snipeexpress/ISA-PC104-Backplane/ISA_PC104 Backplane.kicad_sch

## KiCad design ISA_PC104 Backplane.kicad_sch (2024-09-26)

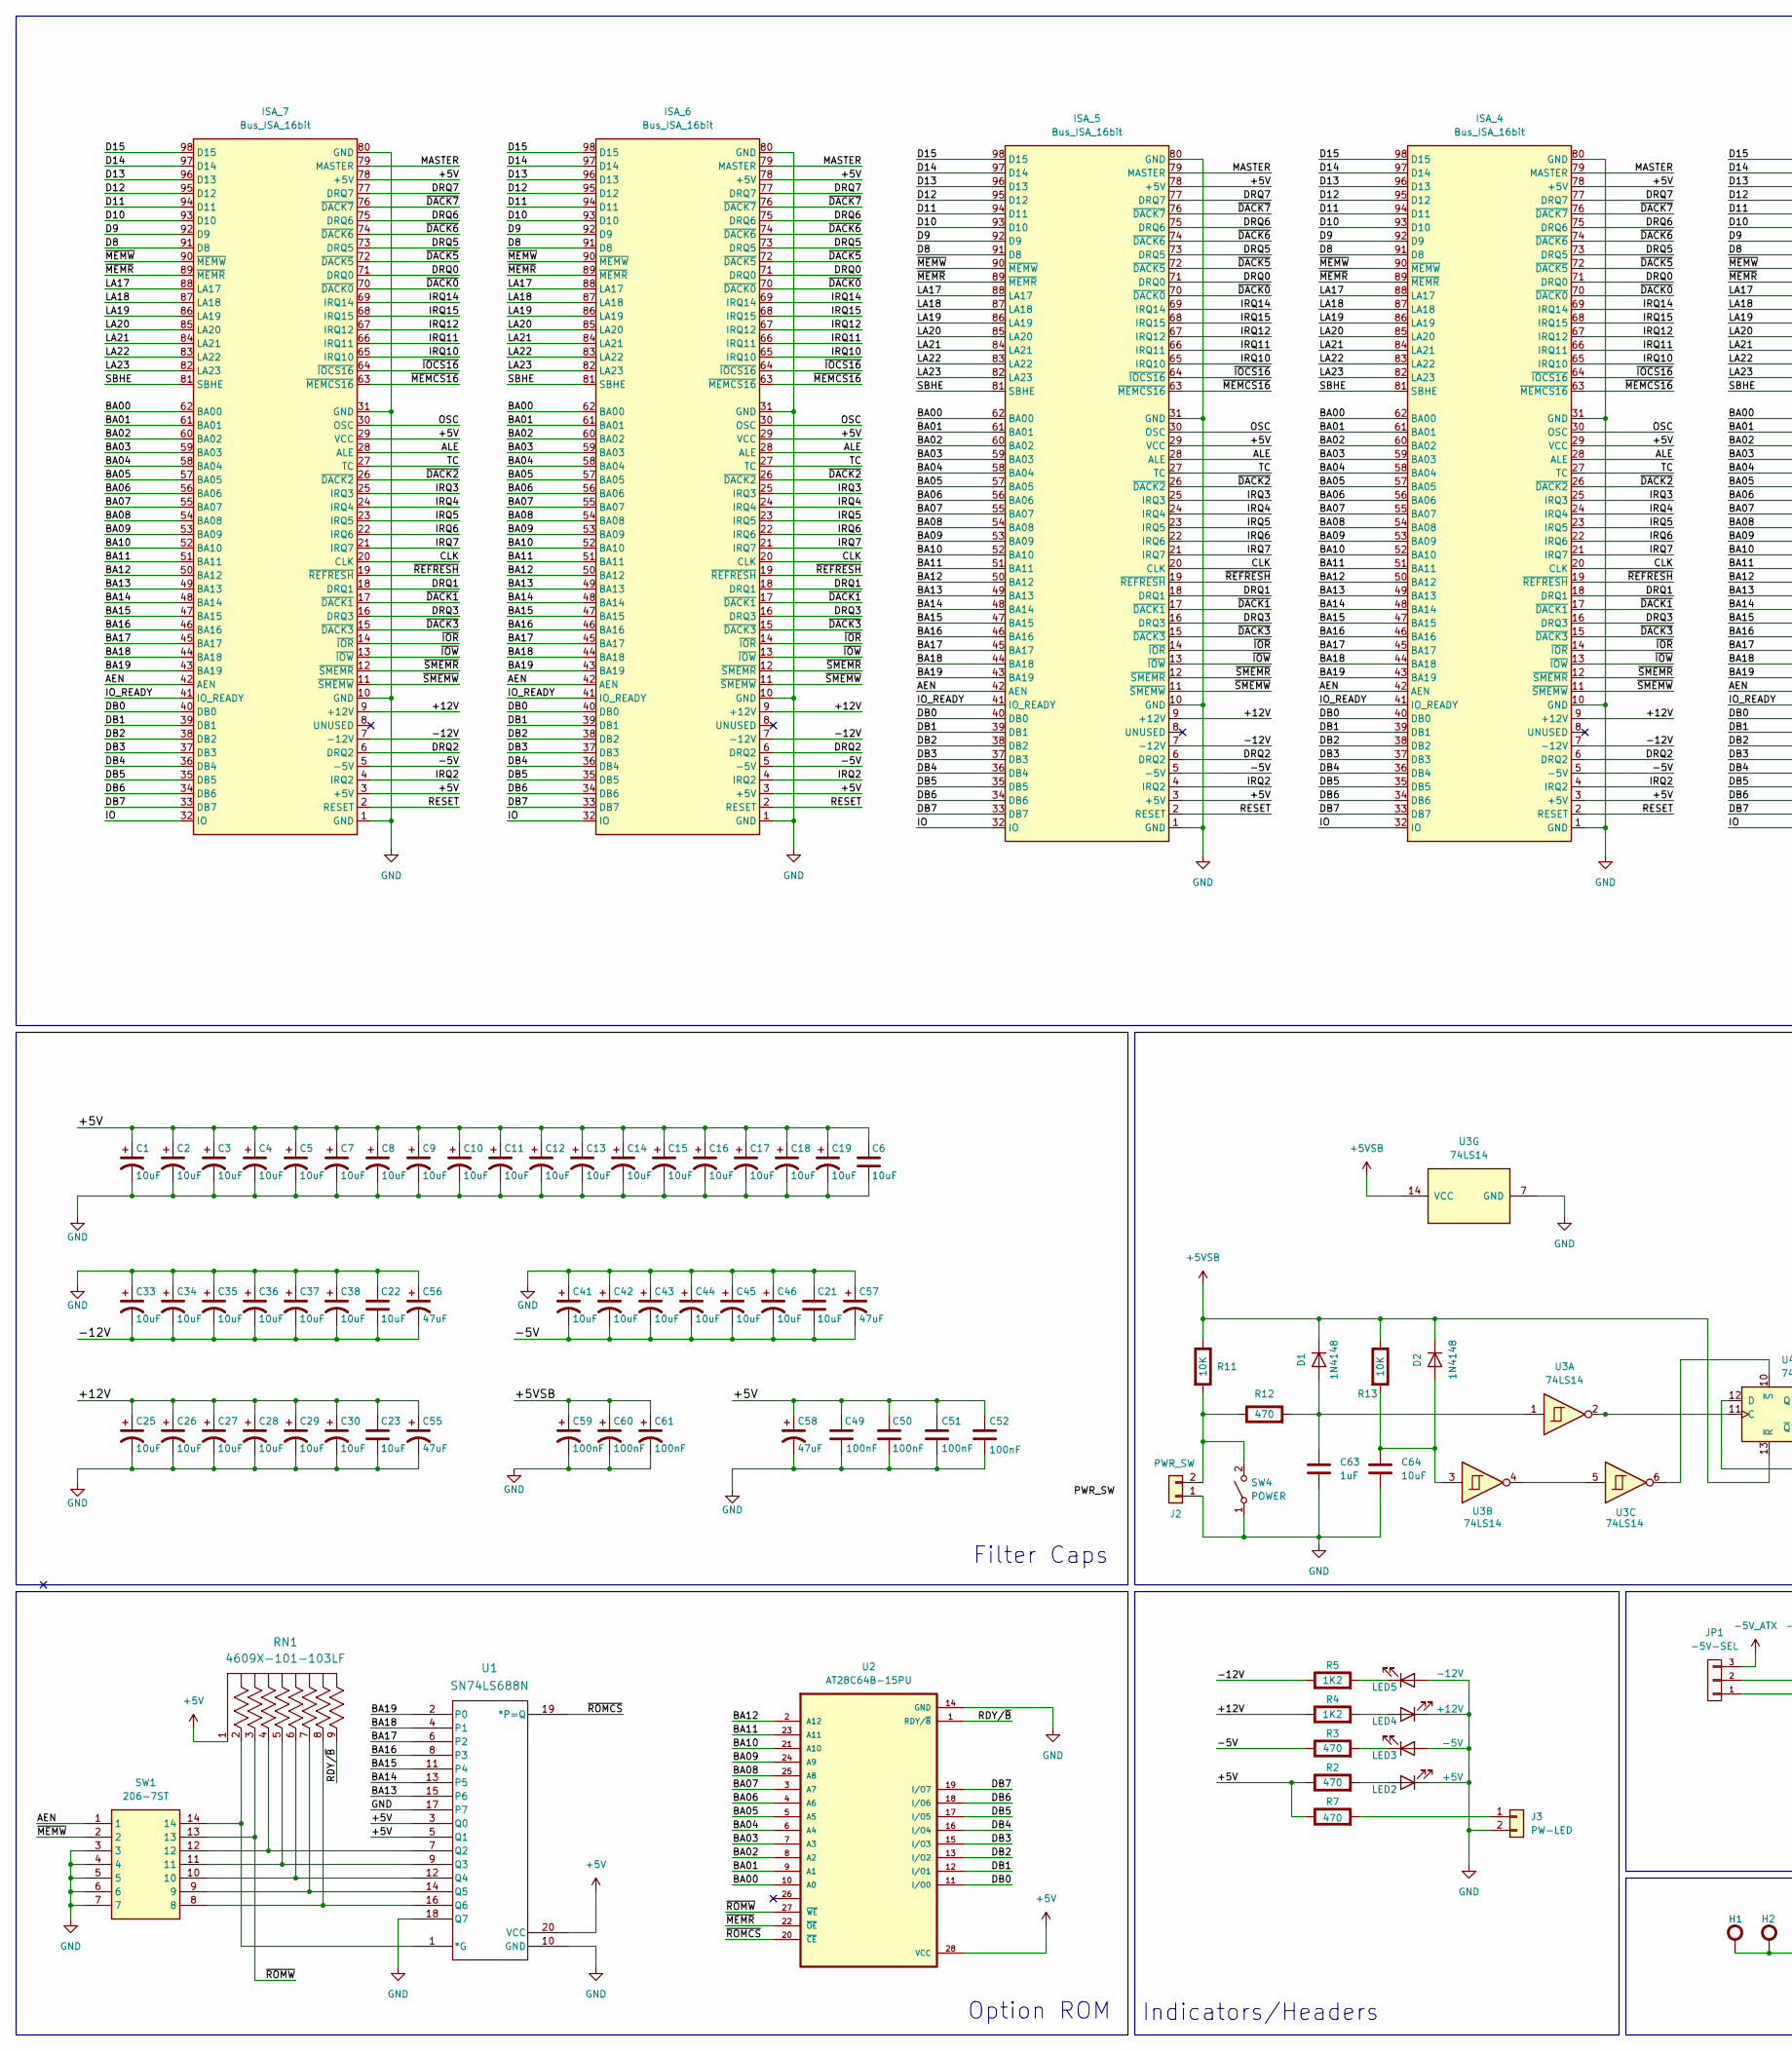
[picture p1: schematic ISA_PC104 Backplane.kicad_sch, part in row 1, column 1]

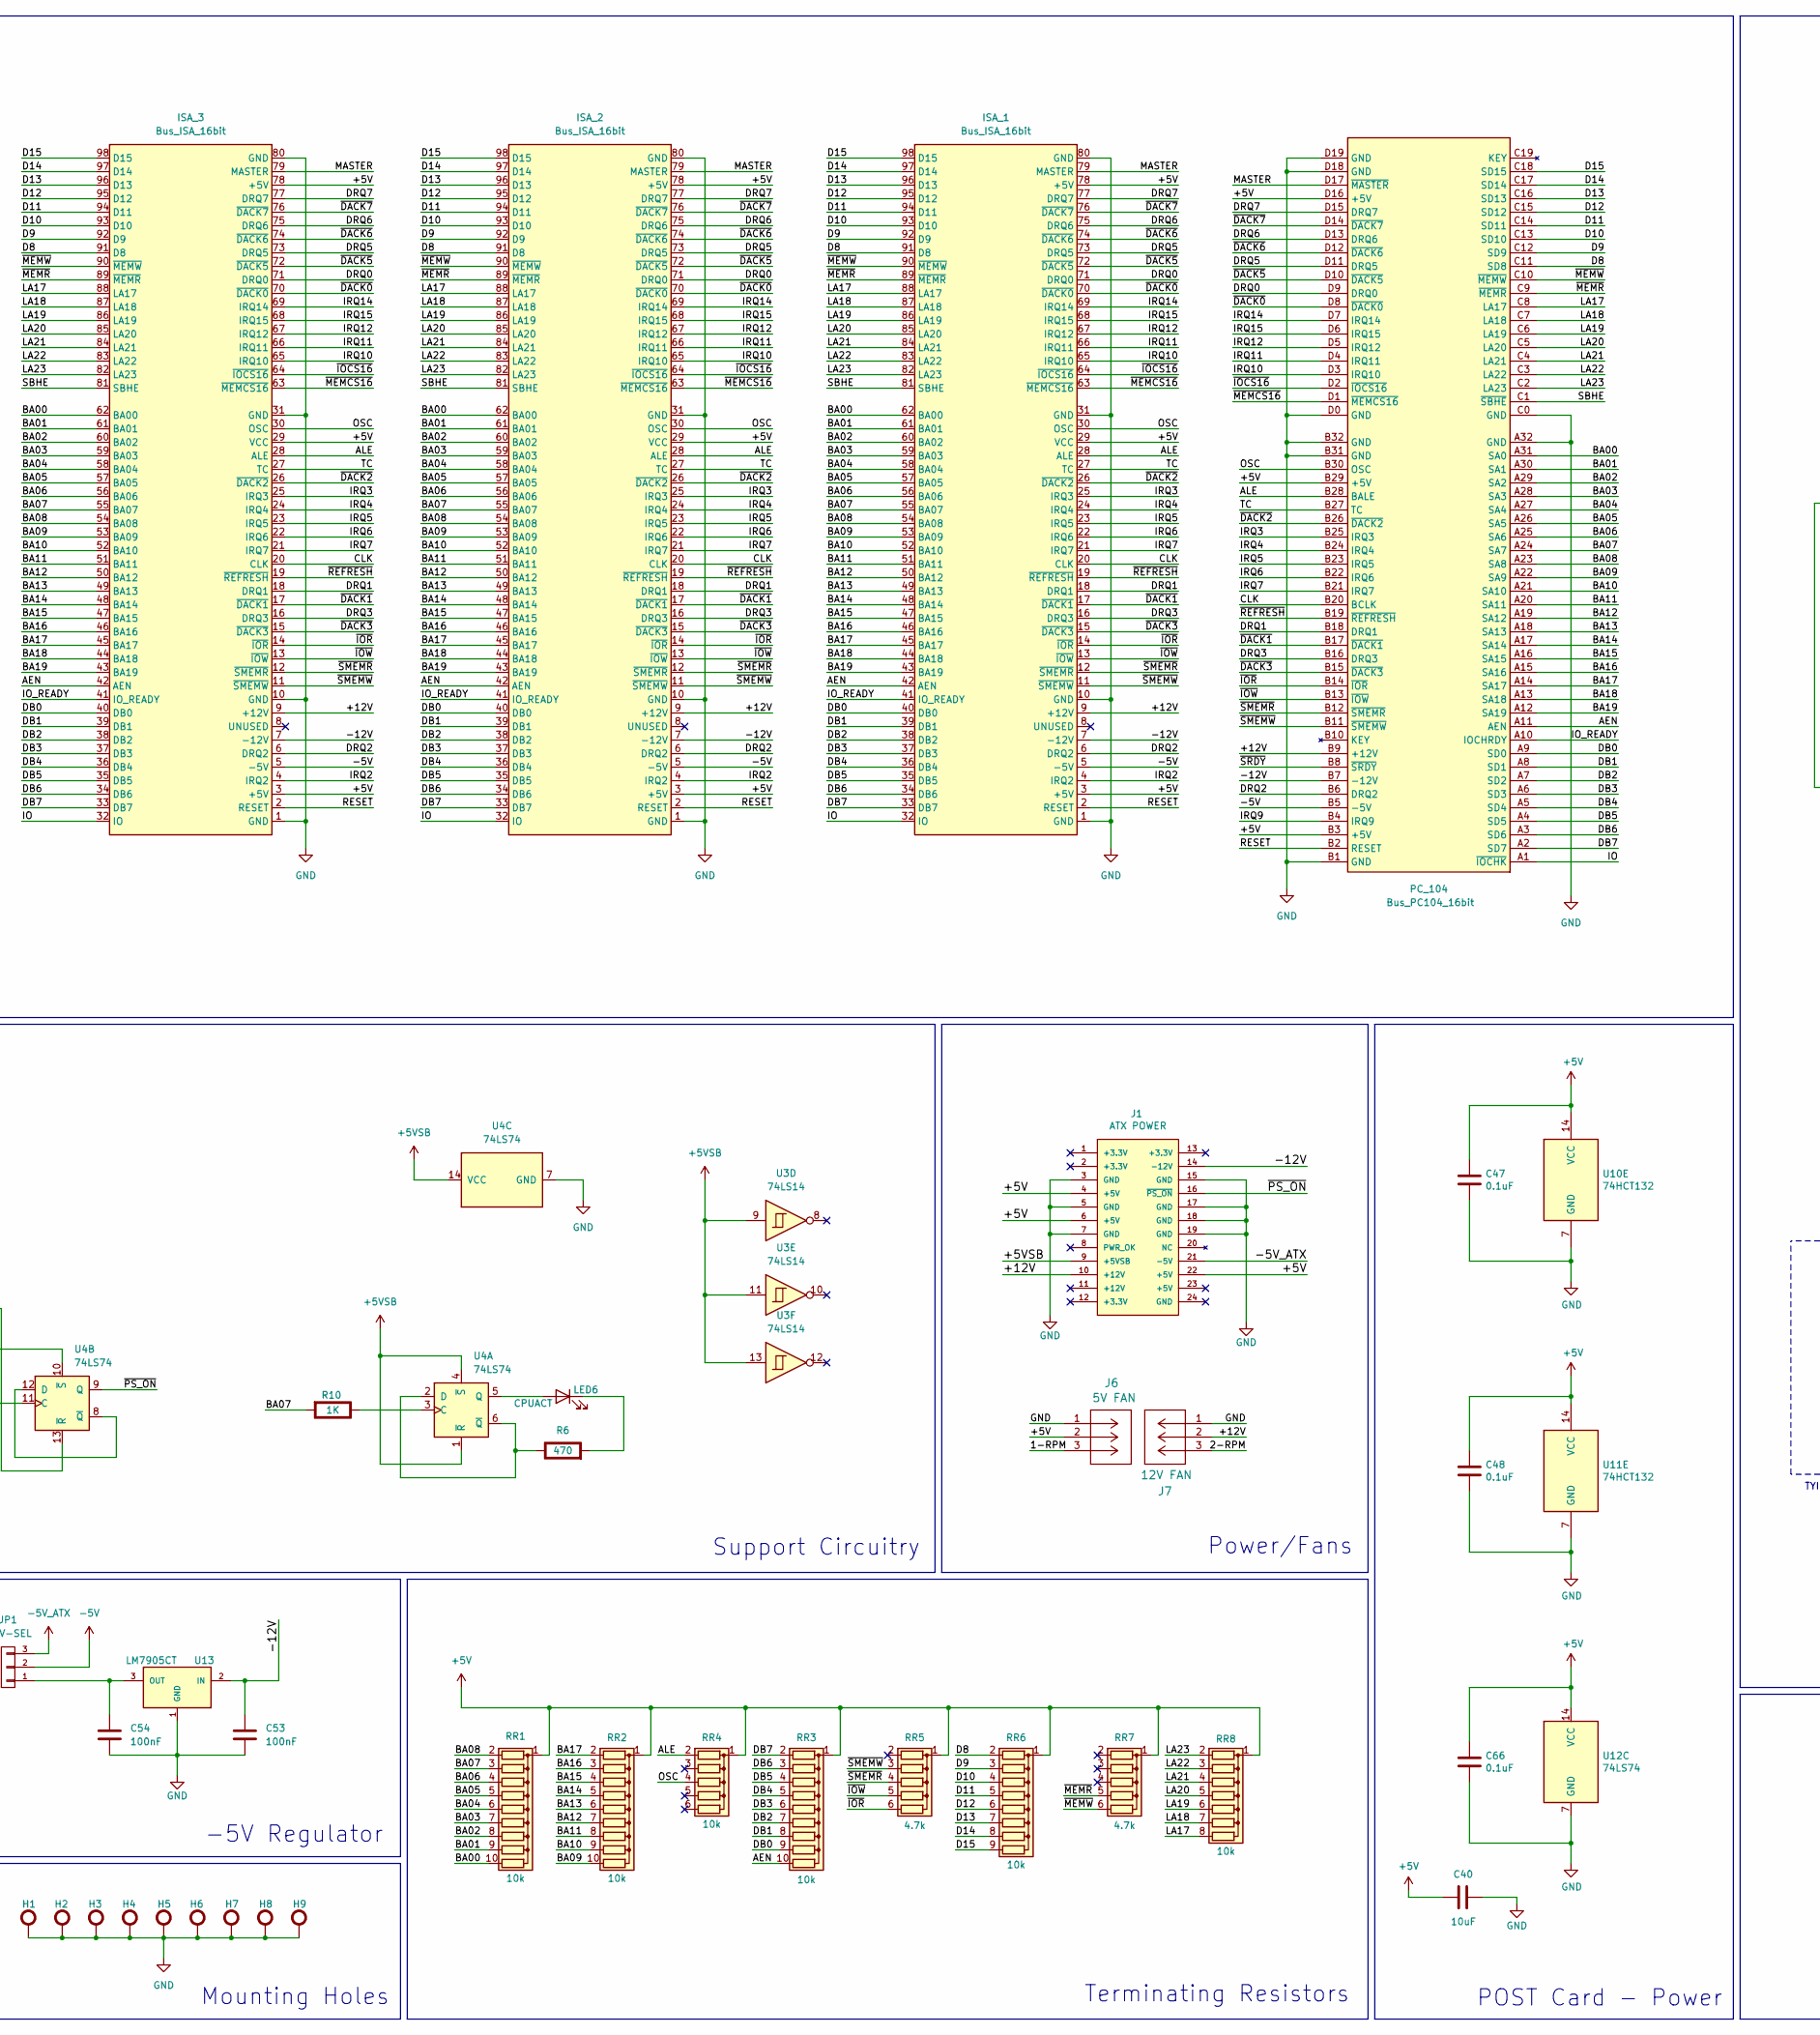
[picture p2: schematic ISA_PC104 Backplane.kicad_sch, part in row 1, column 2]

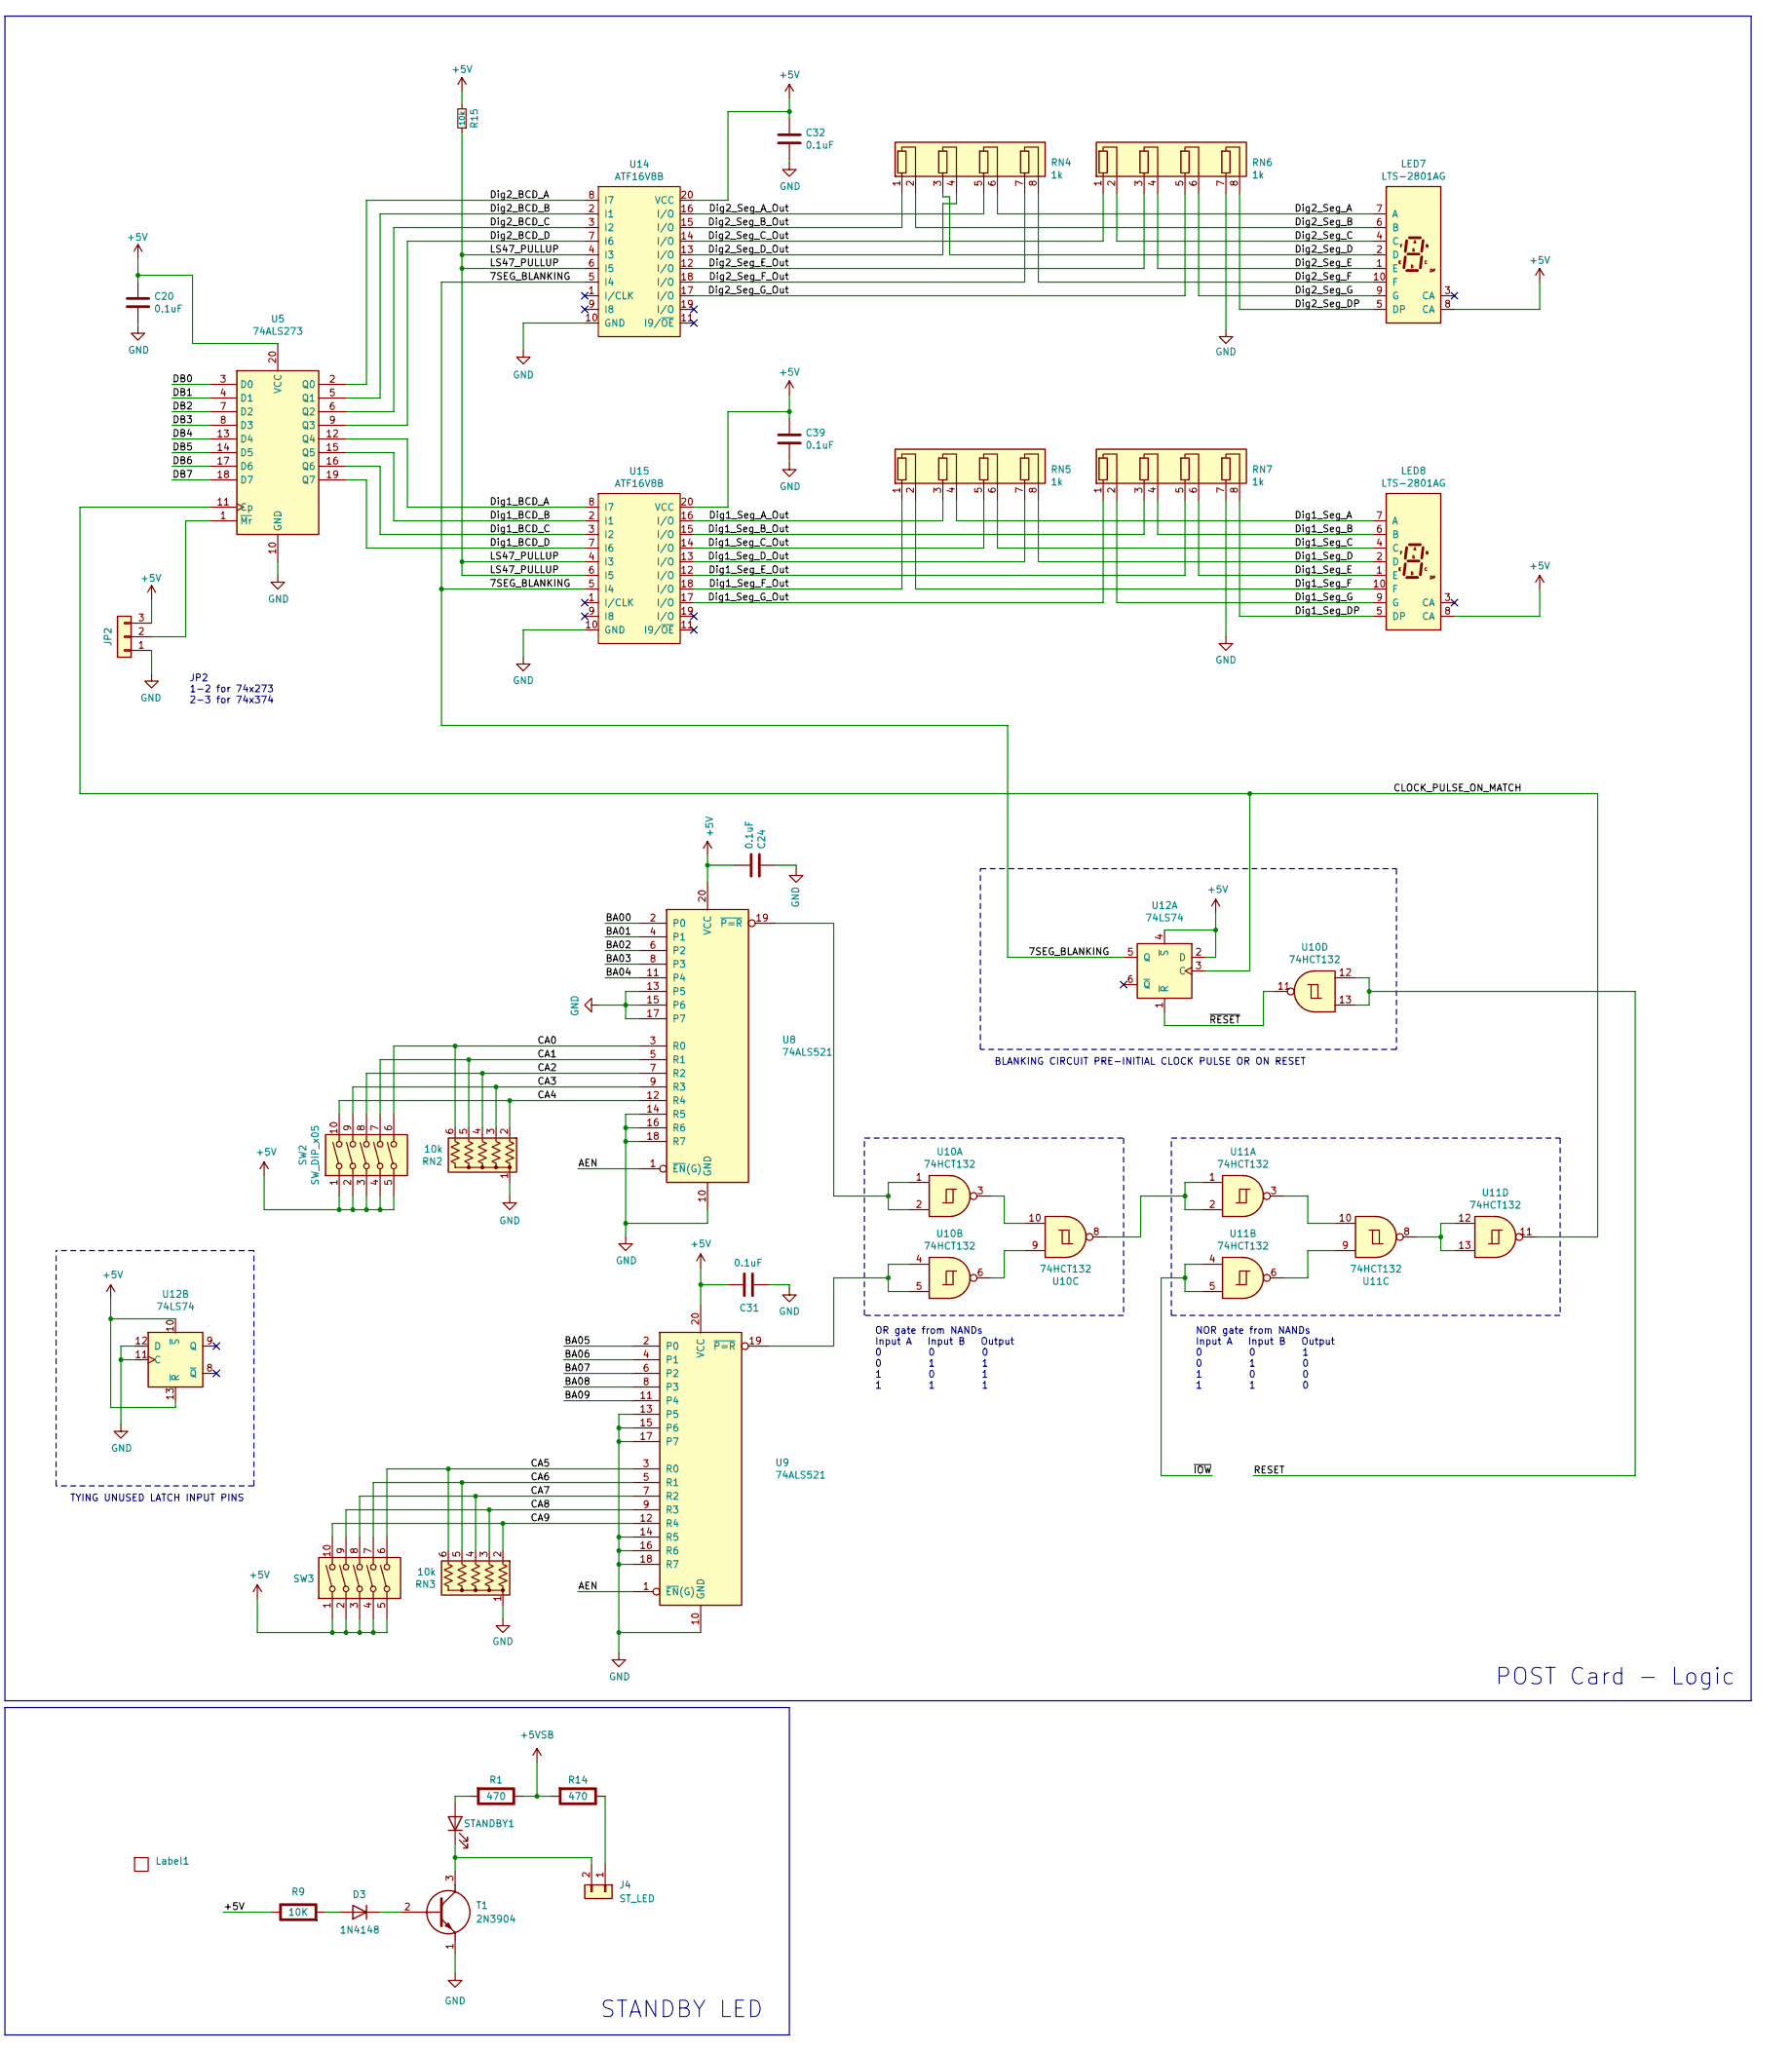
[picture p3: schematic ISA_PC104 Backplane.kicad_sch, part in row 1, column 3]

Parts:
C1, C2, C3, C4, C5, C7, C8, C9, C10, C11, C12, C13, C14, C15, C16, C17, C18, C19, C25, C26, C27, C28, C29, C30, C33, C34, C35, C36, C37, C38, C41, C42, C43, C44, C45, C46, C64: 10uF; CAP_T350E_5p5X5p5-2p54_KEM
C6, C21, C22, C23: 10uF; C_1206_3216Metric
C20, C24, C31, C32, C39, C47, C48, C66: 0.1uF; CAP22
C40: 10uF; CAP22
C49, C50, C51, C52, C53, C54, C59, C60, C61: 100nF; CAP22
C55, C56, C57, C58: 47uF; CAP_PL_10X13_NCH
C63: 1uF; CAP_T350E_5p5X5p5-2p54_KEM
D1, D2, D3: 1N4148; DIOAD990W55L340D162
H1, H2, H3, H4, H5, H6, H7, H8, H9: H_HOLE; MountingHole_4.3mm_M4_Pad_Via
ISA_1, ISA_2, ISA_3, ISA_4, ISA_5, ISA_6, ISA_7: Bus_ISA_16bit; BP_ISA_16BIT_SQ
J1: ATX POWER; J_ATX_5.5mm
J2: PWR_SW; P_CONN_01X02
J3: PW-LED; P_CONN_01X02
J4: ST_LED; P_CONN_01X02
J6: 5V FAN; CONN3_22232031_MOL
J7: 12V FAN; CONN3_22232031_MOL
JP1: -5V-SEL; P_CONN_01X03
JP2: Conn_01x03; P_CONN_01X03
LED2: +5V; LED_D5.0mm
LED3: -5V; LED_D5.0mm
LED4: +12V; LED_D5.0mm
LED5: -12V; LED_D5.0mm
LED6: CPUACT; LED_D5.0mm
LED7, LED8: LTS-2801AG; 7SEG_LED_0.58
Label1: OSHW-Logo2_9.8x8mm_SilkScreen
PC_104: Bus_PC104_16bit; PC104_16bit
R1, R2, R3, R6, R7, R12, R14: 470; STA_CF14_STP; Rating W
R4, R5: 1K2; STA_CF14_STP; Rating W
R9, R11, R13: 10K; STA_CF14_STP; Rating W
R10: 1K; STA_CF14_STP; Rating W
R15: 10k; R_Axial_DIN0207_L6.3mm_D2.5mm_P10.16mm_Horizontal
RN1: 4609X-101-103LF; BO_4609X
RN2, RN3: 10k; R_Array_SIP6
RN4, RN5, RN6, RN7: 1k; R_Array_SIP8
RR1, RR2, RR3: 10k; R_Array_SIP10
RR4: 10k; R_Array_SIP6
RR5, RR7: 4.7k; R_Array_SIP6
RR6: 10k; R_Array_SIP9
RR8: 10k; R_Array_SIP8
STANDBY1: STDBY; LED_D5.0mm
SW1: 206-7ST; Switch_DIP_7_Positions; Mouser Part Number 774-2067ST
SW2, SW3: SW_DIP_x05; SW_DIP_SPSTx05_Slide_9.78x14.88mm_W7.62mm_P2.54mm
SW4: POWER; SW_B3FS-1010
T1: 2N3904; TO92127P495H495-3; Mouser Part Number 610-2N2222
U1: SN74LS688N; DIP300_20N
U2: AT28C64B-15PU; DIP1555W45P254L3733H482Q28; PARTREV B
U3: 74LS14; 1109931441001000
U4: 74LS74; 1109931441001000
U5: 74ALS273; DIP-20_W7.62mm
U8, U9: 74ALS521; DIP-20_W7.62mm
U10, U11: 74HCT132; U_DIP-14_W7.62mm
U12: 74LS74; U_DIP-14_W7.62mm
U13: LM7905CT; SB_TO220
U14, U15: ATF16V8B; DIP-20_W7.62mm

Connections:
1-RPM: J6.3
2-RPM: J7.3
7SEG_BLANKING: U12.5 (Q), U14.5 (I4), U15.5 (I4)
+5V: C1.1, C2.1, C3.1, C4.1, C5.1, C6.1, C7.1, C8.1, C9.1, C10.1, C11.1, C12.1, C13.1, C14.1, C15.1, C16.1, C17.1, C18.1, C19.1, C20.1, C24.2, C31.2, C32.1, C39.1, C40.1, C47.1, C48.1, C49.1, C50.1, C51.1, C52.1, C58.1, C66.1, ISA_1.3 (+5V), ISA_1.29 (VCC), ISA_1.78 (+5V), ISA_2.3 (+5V), ISA_2.29 (VCC), ISA_2.78 (+5V), ISA_3.3 (+5V), ISA_3.29 (VCC), ISA_3.78 (+5V), ISA_4.3 (+5V), ISA_4.29 (VCC), ISA_4.78 (+5V), ISA_5.3 (+5V), ISA_5.29 (VCC), ISA_5.78 (+5V), ISA_6.3 (+5V), ISA_6.29 (VCC), ISA_6.78 (+5V), ISA_7.3 (+5V), ISA_7.29 (VCC), ISA_7.78 (+5V), J1.4 (+5V), J1.6 (+5V), J1.22 (+5V), J6.2, JP2.3, LED7.8 (CA), LED8.8 (CA), PC_104.B3 (+5V), PC_104.B29 (+5V), PC_104.D16 (+5V), R2.1 (+), R7.1 (+), R9.1 (+), R15.2, RN1.1, RR1.1 (common), RR2.1 (common), RR3.1 (common), RR4.1 (common), RR5.1 (common), RR6.1 (common), RR7.1 (common), RR8.1 (common), SW2.1, SW2.2, SW2.3, SW2.4, SW2.5, SW3.1, SW3.2, SW3.3, SW3.4, SW3.5, U1.3 (Q0), U1.5 (Q1), U1.20 (VCC), U2.28 (VCC), U5.20 (VCC), U8.20 (VCC), U9.20 (VCC), U10.14 (VCC), U11.14 (VCC), U12.2 (D), U12.4 (~S), U12.10 (~S), U12.13 (~R), U12.14 (VCC), U14.20 (VCC), U15.20 (VCC)
+5VSB: C59.1, C60.1, C61.1, D1.1 (K), D2.1 (K), J1.9 (+5VSB), R1.1 (+), R11.1 (+), R13.1 (+), R14.2 (-), U3.9, U3.11, U3.13, U3.14 (VCC), U4.1 (~R), U4.4 (~S), U4.13 (~R), U4.14 (VCC)
+12V: C23.1, C25.1, C26.1, C27.1, C28.1, C29.1, C30.1, C55.1, ISA_1.9 (+12V), ISA_2.9 (+12V), ISA_3.9 (+12V), ISA_4.9 (+12V), ISA_5.9 (+12V), ISA_6.9 (+12V), ISA_7.9 (+12V), J1.10 (+12V), J7.2, PC_104.B9 (+12V), R4.1 (+)
-5V: C21.2, C41.2, C42.2, C43.2, C44.2, C45.2, C46.2, C57.2, ISA_1.5 (-5V), ISA_2.5 (-5V), ISA_3.5 (-5V), ISA_4.5 (-5V), ISA_5.5 (-5V), ISA_6.5 (-5V), ISA_7.5 (-5V), JP1.2, PC_104.B5 (-5V), R3.1 (+)
-5V_ATX: J1.21 (-5V), JP1.3
-12V: C22.2, C33.2, C34.2, C35.2, C36.2, C37.2, C38.2, C53.1, C56.2, ISA_1.7 (-12V), ISA_2.7 (-12V), ISA_3.7 (-12V), ISA_4.7 (-12V), ISA_5.7 (-12V), ISA_6.7 (-12V), ISA_7.7 (-12V), J1.14 (-12V), PC_104.B7 (-12V), R5.1 (+), U13.2 (IN)
AEN: ISA_1.42 (AEN), ISA_2.42 (AEN), ISA_3.42 (AEN), ISA_4.42 (AEN), ISA_5.42 (AEN), ISA_6.42 (AEN), ISA_7.42 (AEN), PC_104.A11 (AEN), RR3.10 (R9), SW1.1, U8.1 (~EN(G)), U9.1 (~EN(G))
ALE: ISA_1.28 (ALE), ISA_2.28 (ALE), ISA_3.28 (ALE), ISA_4.28 (ALE), ISA_5.28 (ALE), ISA_6.28 (ALE), ISA_7.28 (ALE), PC_104.B28 (BALE), RR4.2 (R1)
BA00: ISA_1.62 (BA00), ISA_2.62 (BA00), ISA_3.62 (BA00), ISA_4.62 (BA00), ISA_5.62 (BA00), ISA_6.62 (BA00), ISA_7.62 (BA00), PC_104.A31 (SA0), RR1.10 (R9), U2.10 (A0), U8.2 (P0)
BA01: ISA_1.61 (BA01), ISA_2.61 (BA01), ISA_3.61 (BA01), ISA_4.61 (BA01), ISA_5.61 (BA01), ISA_6.61 (BA01), ISA_7.61 (BA01), PC_104.A30 (SA1), RR1.9 (R8), U2.9 (A1), U8.4 (P1)
BA02: ISA_1.60 (BA02), ISA_2.60 (BA02), ISA_3.60 (BA02), ISA_4.60 (BA02), ISA_5.60 (BA02), ISA_6.60 (BA02), ISA_7.60 (BA02), PC_104.A29 (SA2), RR1.8 (R7), U2.8 (A2), U8.6 (P2)
BA03: ISA_1.59 (BA03), ISA_2.59 (BA03), ISA_3.59 (BA03), ISA_4.59 (BA03), ISA_5.59 (BA03), ISA_6.59 (BA03), ISA_7.59 (BA03), PC_104.A28 (SA3), RR1.7 (R6), U2.7 (A3), U8.8 (P3)
BA04: ISA_1.58 (BA04), ISA_2.58 (BA04), ISA_3.58 (BA04), ISA_4.58 (BA04), ISA_5.58 (BA04), ISA_6.58 (BA04), ISA_7.58 (BA04), PC_104.A27 (SA4), RR1.6 (R5), U2.6 (A4), U8.11 (P4)
BA05: ISA_1.57 (BA05), ISA_2.57 (BA05), ISA_3.57 (BA05), ISA_4.57 (BA05), ISA_5.57 (BA05), ISA_6.57 (BA05), ISA_7.57 (BA05), PC_104.A26 (SA5), RR1.5 (R4), U2.5 (A5), U9.2 (P0)
BA06: ISA_1.56 (BA06), ISA_2.56 (BA06), ISA_3.56 (BA06), ISA_4.56 (BA06), ISA_5.56 (BA06), ISA_6.56 (BA06), ISA_7.56 (BA06), PC_104.A25 (SA6), RR1.4 (R3), U2.4 (A6), U9.4 (P1)
BA07: ISA_1.55 (BA07), ISA_2.55 (BA07), ISA_3.55 (BA07), ISA_4.55 (BA07), ISA_5.55 (BA07), ISA_6.55 (BA07), ISA_7.55 (BA07), PC_104.A24 (SA7), R10.2 (-), RR1.3 (R2), U2.3 (A7), U9.6 (P2)
BA08: ISA_1.54 (BA08), ISA_2.54 (BA08), ISA_3.54 (BA08), ISA_4.54 (BA08), ISA_5.54 (BA08), ISA_6.54 (BA08), ISA_7.54 (BA08), PC_104.A23 (SA8), RR1.2 (R1), U2.25 (A8), U9.8 (P3)
BA09: ISA_1.53 (BA09), ISA_2.53 (BA09), ISA_3.53 (BA09), ISA_4.53 (BA09), ISA_5.53 (BA09), ISA_6.53 (BA09), ISA_7.53 (BA09), PC_104.A22 (SA9), RR2.10 (R9), U2.24 (A9), U9.11 (P4)
BA10: ISA_1.52 (BA10), ISA_2.52 (BA10), ISA_3.52 (BA10), ISA_4.52 (BA10), ISA_5.52 (BA10), ISA_6.52 (BA10), ISA_7.52 (BA10), PC_104.A21 (SA10), RR2.9 (R8), U2.21 (A10)
BA11: ISA_1.51 (BA11), ISA_2.51 (BA11), ISA_3.51 (BA11), ISA_4.51 (BA11), ISA_5.51 (BA11), ISA_6.51 (BA11), ISA_7.51 (BA11), PC_104.A20 (SA11), RR2.8 (R7), U2.23 (A11)
BA12: ISA_1.50 (BA12), ISA_2.50 (BA12), ISA_3.50 (BA12), ISA_4.50 (BA12), ISA_5.50 (BA12), ISA_6.50 (BA12), ISA_7.50 (BA12), PC_104.A19 (SA12), RR2.7 (R6), U2.2 (A12)
BA13: ISA_1.49 (BA13), ISA_2.49 (BA13), ISA_3.49 (BA13), ISA_4.49 (BA13), ISA_5.49 (BA13), ISA_6.49 (BA13), ISA_7.49 (BA13), PC_104.A18 (SA13), RR2.6 (R5), U1.15 (P6)
BA14: ISA_1.48 (BA14), ISA_2.48 (BA14), ISA_3.48 (BA14), ISA_4.48 (BA14), ISA_5.48 (BA14), ISA_6.48 (BA14), ISA_7.48 (BA14), PC_104.A17 (SA14), RR2.5 (R4), U1.13 (P5)
BA15: ISA_1.47 (BA15), ISA_2.47 (BA15), ISA_3.47 (BA15), ISA_4.47 (BA15), ISA_5.47 (BA15), ISA_6.47 (BA15), ISA_7.47 (BA15), PC_104.A16 (SA15), RR2.4 (R3), U1.11 (P4)
BA16: ISA_1.46 (BA16), ISA_2.46 (BA16), ISA_3.46 (BA16), ISA_4.46 (BA16), ISA_5.46 (BA16), ISA_6.46 (BA16), ISA_7.46 (BA16), PC_104.A15 (SA16), RR2.3 (R2), U1.8 (P3)
BA17: ISA_1.45 (BA17), ISA_2.45 (BA17), ISA_3.45 (BA17), ISA_4.45 (BA17), ISA_5.45 (BA17), ISA_6.45 (BA17), ISA_7.45 (BA17), PC_104.A14 (SA17), RR2.2 (R1), U1.6 (P2)
BA18: ISA_1.44 (BA18), ISA_2.44 (BA18), ISA_3.44 (BA18), ISA_4.44 (BA18), ISA_5.44 (BA18), ISA_6.44 (BA18), ISA_7.44 (BA18), PC_104.A13 (SA18), U1.4 (P1)
BA19: ISA_1.43 (BA19), ISA_2.43 (BA19), ISA_3.43 (BA19), ISA_4.43 (BA19), ISA_5.43 (BA19), ISA_6.43 (BA19), ISA_7.43 (BA19), PC_104.A12 (SA19), U1.2 (P0)
CA0: RN2.6 (R5), SW2.6, U8.3 (R0)
CA1: RN2.5 (R4), SW2.7, U8.5 (R1)
CA2: RN2.4 (R3), SW2.8, U8.7 (R2)
CA3: RN2.3 (R2), SW2.9, U8.9 (R3)
CA4: RN2.2 (R1), SW2.10, U8.12 (R4)
CA5: RN3.6 (R5), SW3.6, U9.3 (R0)
CA6: RN3.5 (R4), SW3.7, U9.5 (R1)
CA7: RN3.4 (R3), SW3.8, U9.7 (R2)
CA8: RN3.3 (R2), SW3.9, U9.9 (R3)
CA9: RN3.2 (R1), SW3.10, U9.12 (R4)
CLK: ISA_1.20 (CLK), ISA_2.20 (CLK), ISA_3.20 (CLK), ISA_4.20 (CLK), ISA_5.20 (CLK), ISA_6.20 (CLK), ISA_7.20 (CLK), PC_104.B20 (BCLK)
CLOCK_PULSE_ON_MATCH: U5.11 (Cp), U11.11, U12.3 (C)
D8: ISA_1.91 (D8), ISA_2.91 (D8), ISA_3.91 (D8), ISA_4.91 (D8), ISA_5.91 (D8), ISA_6.91 (D8), ISA_7.91 (D8), PC_104.C11 (SD8), RR6.2 (R1)
D9: ISA_1.92 (D9), ISA_2.92 (D9), ISA_3.92 (D9), ISA_4.92 (D9), ISA_5.92 (D9), ISA_6.92 (D9), ISA_7.92 (D9), PC_104.C12 (SD9), RR6.3 (R2)
D10: ISA_1.93 (D10), ISA_2.93 (D10), ISA_3.93 (D10), ISA_4.93 (D10), ISA_5.93 (D10), ISA_6.93 (D10), ISA_7.93 (D10), PC_104.C13 (SD10), RR6.4 (R3)
D11: ISA_1.94 (D11), ISA_2.94 (D11), ISA_3.94 (D11), ISA_4.94 (D11), ISA_5.94 (D11), ISA_6.94 (D11), ISA_7.94 (D11), PC_104.C14 (SD11), RR6.5 (R4)
D12: ISA_1.95 (D12), ISA_2.95 (D12), ISA_3.95 (D12), ISA_4.95 (D12), ISA_5.95 (D12), ISA_6.95 (D12), ISA_7.95 (D12), PC_104.C15 (SD12), RR6.6 (R5)
D13: ISA_1.96 (D13), ISA_2.96 (D13), ISA_3.96 (D13), ISA_4.96 (D13), ISA_5.96 (D13), ISA_6.96 (D13), ISA_7.96 (D13), PC_104.C16 (SD13), RR6.7 (R6)
D14: ISA_1.97 (D14), ISA_2.97 (D14), ISA_3.97 (D14), ISA_4.97 (D14), ISA_5.97 (D14), ISA_6.97 (D14), ISA_7.97 (D14), PC_104.C17 (SD14), RR6.8 (R7)
D15: ISA_1.98 (D15), ISA_2.98 (D15), ISA_3.98 (D15), ISA_4.98 (D15), ISA_5.98 (D15), ISA_6.98 (D15), ISA_7.98 (D15), PC_104.C18 (SD15), RR6.9 (R8)
DB0: ISA_1.40 (DB0), ISA_2.40 (DB0), ISA_3.40 (DB0), ISA_4.40 (DB0), ISA_5.40 (DB0), ISA_6.40 (DB0), ISA_7.40 (DB0), PC_104.A9 (SD0), RR3.9 (R8), U2.11 (I/O0), U5.3 (D0)
DB1: ISA_1.39 (DB1), ISA_2.39 (DB1), ISA_3.39 (DB1), ISA_4.39 (DB1), ISA_5.39 (DB1), ISA_6.39 (DB1), ISA_7.39 (DB1), PC_104.A8 (SD1), RR3.8 (R7), U2.12 (I/O1), U5.4 (D1)
DB2: ISA_1.38 (DB2), ISA_2.38 (DB2), ISA_3.38 (DB2), ISA_4.38 (DB2), ISA_5.38 (DB2), ISA_6.38 (DB2), ISA_7.38 (DB2), PC_104.A7 (SD2), RR3.7 (R6), U2.13 (I/O2), U5.7 (D2)
DB3: ISA_1.37 (DB3), ISA_2.37 (DB3), ISA_3.37 (DB3), ISA_4.37 (DB3), ISA_5.37 (DB3), ISA_6.37 (DB3), ISA_7.37 (DB3), PC_104.A6 (SD3), RR3.6 (R5), U2.15 (I/O3), U5.8 (D3)
DB4: ISA_1.36 (DB4), ISA_2.36 (DB4), ISA_3.36 (DB4), ISA_4.36 (DB4), ISA_5.36 (DB4), ISA_6.36 (DB4), ISA_7.36 (DB4), PC_104.A5 (SD4), RR3.5 (R4), U2.16 (I/O4), U5.13 (D4)
DB5: ISA_1.35 (DB5), ISA_2.35 (DB5), ISA_3.35 (DB5), ISA_4.35 (DB5), ISA_5.35 (DB5), ISA_6.35 (DB5), ISA_7.35 (DB5), PC_104.A4 (SD5), RR3.4 (R3), U2.17 (I/O5), U5.14 (D5)
DB6: ISA_1.34 (DB6), ISA_2.34 (DB6), ISA_3.34 (DB6), ISA_4.34 (DB6), ISA_5.34 (DB6), ISA_6.34 (DB6), ISA_7.34 (DB6), PC_104.A3 (SD6), RR3.3 (R2), U2.18 (I/O6), U5.17 (D6)
DB7: ISA_1.33 (DB7), ISA_2.33 (DB7), ISA_3.33 (DB7), ISA_4.33 (DB7), ISA_5.33 (DB7), ISA_6.33 (DB7), ISA_7.33 (DB7), PC_104.A2 (SD7), RR3.2 (R1), U2.19 (I/O7), U5.18 (D7)
DRQ0: ISA_1.71 (DRQ0), ISA_2.71 (DRQ0), ISA_3.71 (DRQ0), ISA_4.71 (DRQ0), ISA_5.71 (DRQ0), ISA_6.71 (DRQ0), ISA_7.71 (DRQ0), PC_104.D9 (DRQ0)
DRQ1: ISA_1.18 (DRQ1), ISA_2.18 (DRQ1), ISA_3.18 (DRQ1), ISA_4.18 (DRQ1), ISA_5.18 (DRQ1), ISA_6.18 (DRQ1), ISA_7.18 (DRQ1), PC_104.B18 (DRQ1)
DRQ2: ISA_1.6 (DRQ2), ISA_2.6 (DRQ2), ISA_3.6 (DRQ2), ISA_4.6 (DRQ2), ISA_5.6 (DRQ2), ISA_6.6 (DRQ2), ISA_7.6 (DRQ2), PC_104.B6 (DRQ2)
DRQ3: ISA_1.16 (DRQ3), ISA_2.16 (DRQ3), ISA_3.16 (DRQ3), ISA_4.16 (DRQ3), ISA_5.16 (DRQ3), ISA_6.16 (DRQ3), ISA_7.16 (DRQ3), PC_104.B16 (DRQ3)
DRQ5: ISA_1.73 (DRQ5), ISA_2.73 (DRQ5), ISA_3.73 (DRQ5), ISA_4.73 (DRQ5), ISA_5.73 (DRQ5), ISA_6.73 (DRQ5), ISA_7.73 (DRQ5), PC_104.D11 (DRQ5)
DRQ6: ISA_1.75 (DRQ6), ISA_2.75 (DRQ6), ISA_3.75 (DRQ6), ISA_4.75 (DRQ6), ISA_5.75 (DRQ6), ISA_6.75 (DRQ6), ISA_7.75 (DRQ6), PC_104.D13 (DRQ6)
DRQ7: ISA_1.77 (DRQ7), ISA_2.77 (DRQ7), ISA_3.77 (DRQ7), ISA_4.77 (DRQ7), ISA_5.77 (DRQ7), ISA_6.77 (DRQ7), ISA_7.77 (DRQ7), PC_104.D15 (DRQ7)
Dig1_BCD_A: U5.12 (Q4), U15.8 (I7)
Dig1_BCD_B: U5.15 (Q5), U15.2 (I1)
Dig1_BCD_C: U5.16 (Q6), U15.3 (I2)
Dig1_BCD_D: U5.19 (Q7), U15.7 (I6)
Dig1_Seg_A: LED8.7 (A), RN5.4 (R2.2)
Dig1_Seg_A_Out: RN5.3 (R2.1), U15.16 (I/O)
Dig1_Seg_B: LED8.6 (B), RN7.4 (R2.2)
Dig1_Seg_B_Out: RN7.3 (R2.1), U15.15 (I/O)
Dig1_Seg_C: LED8.4 (C), RN5.6 (R3.2)
Dig1_Seg_C_Out: RN5.5 (R3.1), U15.14 (I/O)
Dig1_Seg_D: LED8.2 (D), RN5.8 (R4.2)
Dig1_Seg_DP: LED8.5 (DP), RN7.8 (R4.2)
Dig1_Seg_D_Out: RN5.7 (R4.1), U15.13 (I/O)
Dig1_Seg_E: LED8.1 (E), RN7.6 (R3.2)
Dig1_Seg_E_Out: RN7.5 (R3.1), U15.12 (I/O)
Dig1_Seg_F: LED8.10 (F), RN5.2 (R1.2)
Dig1_Seg_F_Out: RN5.1 (R1.1), U15.18 (I/O)
Dig1_Seg_G: LED8.9 (G), RN7.2 (R1.2)
Dig1_Seg_G_Out: RN7.1 (R1.1), U15.17 (I/O)
Dig2_BCD_A: U5.2 (Q0), U14.8 (I7)
Dig2_BCD_B: U5.5 (Q1), U14.2 (I1)
Dig2_BCD_C: U5.6 (Q2), U14.3 (I2)
Dig2_BCD_D: U5.9 (Q3), U14.7 (I6)
Dig2_Seg_A: LED7.7 (A), RN4.6 (R3.2)
Dig2_Seg_A_Out: RN4.5 (R3.1), U14.16 (I/O)
Dig2_Seg_B: LED7.6 (B), RN4.2 (R1.2)
Dig2_Seg_B_Out: RN4.1 (R1.1), U14.15 (I/O)
Dig2_Seg_C: LED7.4 (C), RN6.2 (R1.2)
Dig2_Seg_C_Out: RN6.1 (R1.1), U14.14 (I/O)
Dig2_Seg_D: LED7.2 (D), RN4.3 (R2.1)
Dig2_Seg_DP: LED7.5 (DP), RN6.8 (R4.2)
Dig2_Seg_D_Out: RN4.4 (R2.2), U14.13 (I/O)
Dig2_Seg_E: LED7.1 (E), RN6.4 (R2.2)
Dig2_Seg_E_Out: RN6.3 (R2.1), U14.12 (I/O)
Dig2_Seg_F: LED7.10 (F), RN4.8 (R4.2)
Dig2_Seg_F_Out: RN4.7 (R4.1), U14.18 (I/O)
Dig2_Seg_G: LED7.9 (G), RN6.6 (R3.2)
Dig2_Seg_G_Out: RN6.5 (R3.1), U14.17 (I/O)
GND: C1.2, C2.2, C3.2, C4.2, C5.2, C6.2, C7.2, C8.2, C9.2, C10.2, C11.2, C12.2, C13.2, C14.2, C15.2, C16.2, C17.2, C18.2, C19.2, C20.2, C21.1, C22.1, C23.2, C24.1, C25.2, C26.2, C27.2, C28.2, C29.2, C30.2, C31.1, C32.2, C33.1, C34.1, C35.1, C36.1, C37.1, C38.1, C39.2, C40.2, C41.1, C42.1, C43.1, C44.1, C45.1, C46.1, C47.2, C48.2, C49.2, C50.2, C51.2, C52.2, C53.2, C54.2, C55.2, C56.1, C57.1, C58.2, C59.2, C60.2, C61.2, C63.2, C64.2, C66.2, H1.1, H2.1, H3.1, H4.1, H5.1, H6.1, H7.1, H8.1, H9.1, ISA_1.1 (GND), ISA_1.10 (GND), ISA_1.31 (GND), ISA_1.80 (GND), ISA_2.1 (GND), ISA_2.10 (GND), ISA_2.31 (GND), ISA_2.80 (GND), ISA_3.1 (GND), ISA_3.10 (GND), ISA_3.31 (GND), ISA_3.80 (GND), ISA_4.1 (GND), ISA_4.10 (GND), ISA_4.31 (GND), ISA_4.80 (GND), ISA_5.1 (GND), ISA_5.10 (GND), ISA_5.31 (GND), ISA_5.80 (GND), ISA_6.1 (GND), ISA_6.10 (GND), ISA_6.31 (GND), ISA_6.80 (GND), ISA_7.1 (GND), ISA_7.10 (GND), ISA_7.31 (GND), ISA_7.80 (GND), J1.3 (GND), J1.5 (GND), J1.7 (GND), J1.15 (GND), J1.17 (GND), J1.18 (GND), J1.19 (GND), J2.1, J3.2, J6.1, J7.1, JP2.1, LED2.1 (K), LED3.2 (A), LED4.1 (K), LED5.2 (A), PC_104.A32 (GND), PC_104.B1 (GND), PC_104.B31 (GND), PC_104.B32 (GND), PC_104.C0 (GND), PC_104.D0 (GND), PC_104.D18 (GND), PC_104.D19 (GND), RN2.1 (common), RN3.1 (common), RN6.7 (R4.1), RN7.7 (R4.1), SW1.3, SW1.4, SW1.5, SW1.6, SW1.7, SW4.1 (A), T1.1 (E), U1.10 (GND), U1.17 (P7), U1.18 (Q7), U2.14 (GND), U3.7 (GND), U4.7 (GND), U5.10 (GND), U8.10 (GND), U8.13 (P5), U8.14 (R5), U8.15 (P6), U8.16 (R6), U8.17 (P7), U8.18 (R7), U9.10 (GND), U9.13 (P5), U9.14 (R5), U9.15 (P6), U9.16 (R6), U9.17 (P7), U9.18 (R7), U10.7 (GND), U11.7 (GND), U12.7 (GND), U12.11 (C), U12.12 (D), U13.1 (GND), U14.10 (GND), U15.10 (GND)
IO: ISA_1.32 (IO), ISA_2.32 (IO), ISA_3.32 (IO), ISA_4.32 (IO), ISA_5.32 (IO), ISA_6.32 (IO), ISA_7.32 (IO), PC_104.A1 (~IOCHK)
IO_READY: ISA_1.41 (IO_READY), ISA_2.41 (IO_READY), ISA_3.41 (IO_READY), ISA_4.41 (IO_READY), ISA_5.41 (IO_READY), ISA_6.41 (IO_READY), ISA_7.41 (IO_READY), PC_104.A10 (IOCHRDY)
IRQ2: ISA_1.4 (IRQ2), ISA_2.4 (IRQ2), ISA_3.4 (IRQ2), ISA_4.4 (IRQ2), ISA_5.4 (IRQ2), ISA_6.4 (IRQ2), ISA_7.4 (IRQ2)
IRQ3: ISA_1.25 (IRQ3), ISA_2.25 (IRQ3), ISA_3.25 (IRQ3), ISA_4.25 (IRQ3), ISA_5.25 (IRQ3), ISA_6.25 (IRQ3), ISA_7.25 (IRQ3), PC_104.B25 (IRQ3)
IRQ4: ISA_1.24 (IRQ4), ISA_2.24 (IRQ4), ISA_3.24 (IRQ4), ISA_4.24 (IRQ4), ISA_5.24 (IRQ4), ISA_6.24 (IRQ4), ISA_7.24 (IRQ4), PC_104.B24 (IRQ4)
IRQ5: ISA_1.23 (IRQ5), ISA_2.23 (IRQ5), ISA_3.23 (IRQ5), ISA_4.23 (IRQ5), ISA_5.23 (IRQ5), ISA_6.23 (IRQ5), ISA_7.23 (IRQ5), PC_104.B23 (IRQ5)
IRQ6: ISA_1.22 (IRQ6), ISA_2.22 (IRQ6), ISA_3.22 (IRQ6), ISA_4.22 (IRQ6), ISA_5.22 (IRQ6), ISA_6.22 (IRQ6), ISA_7.22 (IRQ6), PC_104.B22 (IRQ6)
IRQ7: ISA_1.21 (IRQ7), ISA_2.21 (IRQ7), ISA_3.21 (IRQ7), ISA_4.21 (IRQ7), ISA_5.21 (IRQ7), ISA_6.21 (IRQ7), ISA_7.21 (IRQ7), PC_104.B21 (IRQ7)
IRQ9: PC_104.B4 (IRQ9)
IRQ10: ISA_1.65 (IRQ10), ISA_2.65 (IRQ10), ISA_3.65 (IRQ10), ISA_4.65 (IRQ10), ISA_5.65 (IRQ10), ISA_6.65 (IRQ10), ISA_7.65 (IRQ10), PC_104.D3 (IRQ10)
IRQ11: ISA_1.66 (IRQ11), ISA_2.66 (IRQ11), ISA_3.66 (IRQ11), ISA_4.66 (IRQ11), ISA_5.66 (IRQ11), ISA_6.66 (IRQ11), ISA_7.66 (IRQ11), PC_104.D4 (IRQ11)
IRQ12: ISA_1.67 (IRQ12), ISA_2.67 (IRQ12), ISA_3.67 (IRQ12), ISA_4.67 (IRQ12), ISA_5.67 (IRQ12), ISA_6.67 (IRQ12), ISA_7.67 (IRQ12), PC_104.D5 (IRQ12)
IRQ14: ISA_1.69 (IRQ14), ISA_2.69 (IRQ14), ISA_3.69 (IRQ14), ISA_4.69 (IRQ14), ISA_5.69 (IRQ14), ISA_6.69 (IRQ14), ISA_7.69 (IRQ14), PC_104.D7 (IRQ14)
IRQ15: ISA_1.68 (IRQ15), ISA_2.68 (IRQ15), ISA_3.68 (IRQ15), ISA_4.68 (IRQ15), ISA_5.68 (IRQ15), ISA_6.68 (IRQ15), ISA_7.68 (IRQ15), PC_104.D6 (IRQ15)
LA17: ISA_1.88 (LA17), ISA_2.88 (LA17), ISA_3.88 (LA17), ISA_4.88 (LA17), ISA_5.88 (LA17), ISA_6.88 (LA17), ISA_7.88 (LA17), PC_104.C8 (LA17), RR8.8 (R7)
LA18: ISA_1.87 (LA18), ISA_2.87 (LA18), ISA_3.87 (LA18), ISA_4.87 (LA18), ISA_5.87 (LA18), ISA_6.87 (LA18), ISA_7.87 (LA18), PC_104.C7 (LA18), RR8.7 (R6)
LA19: ISA_1.86 (LA19), ISA_2.86 (LA19), ISA_3.86 (LA19), ISA_4.86 (LA19), ISA_5.86 (LA19), ISA_6.86 (LA19), ISA_7.86 (LA19), PC_104.C6 (LA19), RR8.6 (R5)
LA20: ISA_1.85 (LA20), ISA_2.85 (LA20), ISA_3.85 (LA20), ISA_4.85 (LA20), ISA_5.85 (LA20), ISA_6.85 (LA20), ISA_7.85 (LA20), PC_104.C5 (LA20), RR8.5 (R4)
LA21: ISA_1.84 (LA21), ISA_2.84 (LA21), ISA_3.84 (LA21), ISA_4.84 (LA21), ISA_5.84 (LA21), ISA_6.84 (LA21), ISA_7.84 (LA21), PC_104.C4 (LA21), RR8.4 (R3)
LA22: ISA_1.83 (LA22), ISA_2.83 (LA22), ISA_3.83 (LA22), ISA_4.83 (LA22), ISA_5.83 (LA22), ISA_6.83 (LA22), ISA_7.83 (LA22), PC_104.C3 (LA22), RR8.3 (R2)
LA23: ISA_1.82 (LA23), ISA_2.82 (LA23), ISA_3.82 (LA23), ISA_4.82 (LA23), ISA_5.82 (LA23), ISA_6.82 (LA23), ISA_7.82 (LA23), PC_104.C2 (LA23), RR8.2 (R1)
LS47_PULLUP: R15.1, U14.4 (I3), U14.6 (I5), U15.4 (I3), U15.6 (I5)
MASTER: ISA_1.79 (MASTER), ISA_2.79 (MASTER), ISA_3.79 (MASTER), ISA_4.79 (MASTER), ISA_5.79 (MASTER), ISA_6.79 (MASTER), ISA_7.79 (MASTER), PC_104.D17 (~MASTER)
unnamed: C54.1, JP1.1, U13.3 (OUT)
unnamed: C63.1, D1.2 (A), R12.2 (-), U3.1
unnamed: C64.1, D2.2 (A), R13.2 (-), U3.3
unnamed: D3.1 (K), T1.2 (B)
unnamed: D3.2 (A), R9.2 (-)
unnamed: J2.2, R11.2 (-), R12.1 (+), SW4.2 (B)
unnamed: J3.1, R7.2 (-)
unnamed: J4.1, R14.1 (+)
unnamed: J4.2, STANDBY1.1 (K), T1.3 (C)
unnamed: JP2.2, U5.1 (~Mr)
unnamed: LED2.2 (A), R2.2 (-)
unnamed: LED3.1 (K), R3.2 (-)
unnamed: LED4.2 (A), R4.2 (-)
unnamed: LED5.1 (K), R5.2 (-)
unnamed: LED6.1 (K), R6.2 (-)
unnamed: LED6.2 (A), U4.5 (Q)
unnamed: R1.2 (-), STANDBY1.2 (A)
unnamed: R6.1 (+), U4.2 (D), U4.6 (~Q)
unnamed: R10.1 (+), U4.3 (C)
unnamed: RN1.2, SW1.14, U1.1 (*G)
unnamed: RN1.4, SW1.12, U1.7 (Q2)
unnamed: RN1.5, SW1.11, U1.9 (Q3)
unnamed: RN1.6, SW1.10, U1.12 (Q4)
unnamed: RN1.7, SW1.9, U1.14 (Q5)
unnamed: RN1.8, SW1.8, U1.16 (Q6)
unnamed: U3.2, U4.11 (C)
unnamed: U3.4, U3.5
unnamed: U3.6, U4.10 (~S)
unnamed: U4.8 (~Q), U4.12 (D)
unnamed: U8.19 (~P=R), U10.1, U10.2
unnamed: U9.19 (~P=R), U10.4, U10.5
unnamed: U10.6, U10.9
unnamed: U10.8, U11.1, U11.2
unnamed: U10.3, U10.10
unnamed: U11.6, U11.9
unnamed: U11.3, U11.10
unnamed: U11.8, U11.12, U11.13
OSC: ISA_1.30 (OSC), ISA_2.30 (OSC), ISA_3.30 (OSC), ISA_4.30 (OSC), ISA_5.30 (OSC), ISA_6.30 (OSC), ISA_7.30 (OSC), PC_104.B30 (OSC), RR4.4 (R3)
RDY/~B: RN1.9, U2.1 (RDY/~B)
RESET: ISA_1.2 (RESET), ISA_2.2 (RESET), ISA_3.2 (RESET), ISA_4.2 (RESET), ISA_5.2 (RESET), ISA_6.2 (RESET), ISA_7.2 (RESET), PC_104.B2 (RESET), U10.12, U10.13
SBHE: ISA_1.81 (SBHE), ISA_2.81 (SBHE), ISA_3.81 (SBHE), ISA_4.81 (SBHE), ISA_5.81 (SBHE), ISA_6.81 (SBHE), ISA_7.81 (SBHE), PC_104.C1 (~SBHE)
TC: ISA_1.27 (TC), ISA_2.27 (TC), ISA_3.27 (TC), ISA_4.27 (TC), ISA_5.27 (TC), ISA_6.27 (TC), ISA_7.27 (TC), PC_104.B27 (TC)
~DACK0: ISA_1.70 (~DACK0), ISA_2.70 (~DACK0), ISA_3.70 (~DACK0), ISA_4.70 (~DACK0), ISA_5.70 (~DACK0), ISA_6.70 (~DACK0), ISA_7.70 (~DACK0), PC_104.D8 (~DACK0)
~DACK1: ISA_1.17 (~DACK1), ISA_2.17 (~DACK1), ISA_3.17 (~DACK1), ISA_4.17 (~DACK1), ISA_5.17 (~DACK1), ISA_6.17 (~DACK1), ISA_7.17 (~DACK1), PC_104.B17 (~DACK1)
~DACK2: ISA_1.26 (~DACK2), ISA_2.26 (~DACK2), ISA_3.26 (~DACK2), ISA_4.26 (~DACK2), ISA_5.26 (~DACK2), ISA_6.26 (~DACK2), ISA_7.26 (~DACK2), PC_104.B26 (~DACK2)
~DACK3: ISA_1.15 (~DACK3), ISA_2.15 (~DACK3), ISA_3.15 (~DACK3), ISA_4.15 (~DACK3), ISA_5.15 (~DACK3), ISA_6.15 (~DACK3), ISA_7.15 (~DACK3), PC_104.B15 (~DACK3)
~DACK5: ISA_1.72 (~DACK5), ISA_2.72 (~DACK5), ISA_3.72 (~DACK5), ISA_4.72 (~DACK5), ISA_5.72 (~DACK5), ISA_6.72 (~DACK5), ISA_7.72 (~DACK5), PC_104.D10 (~DACK5)
~DACK6: ISA_1.74 (~DACK6), ISA_2.74 (~DACK6), ISA_3.74 (~DACK6), ISA_4.74 (~DACK6), ISA_5.74 (~DACK6), ISA_6.74 (~DACK6), ISA_7.74 (~DACK6), PC_104.D12 (~DACK6)
~DACK7: ISA_1.76 (~DACK7), ISA_2.76 (~DACK7), ISA_3.76 (~DACK7), ISA_4.76 (~DACK7), ISA_5.76 (~DACK7), ISA_6.76 (~DACK7), ISA_7.76 (~DACK7), PC_104.D14 (~DACK7)
~IOCS16: ISA_1.64 (~IOCS16), ISA_2.64 (~IOCS16), ISA_3.64 (~IOCS16), ISA_4.64 (~IOCS16), ISA_5.64 (~IOCS16), ISA_6.64 (~IOCS16), ISA_7.64 (~IOCS16), PC_104.D2 (~IOCS16)
~IOR: ISA_1.14 (~IOR), ISA_2.14 (~IOR), ISA_3.14 (~IOR), ISA_4.14 (~IOR), ISA_5.14 (~IOR), ISA_6.14 (~IOR), ISA_7.14 (~IOR), PC_104.B14 (~IOR), RR5.6 (R5)
~IOW: ISA_1.13 (~IOW), ISA_2.13 (~IOW), ISA_3.13 (~IOW), ISA_4.13 (~IOW), ISA_5.13 (~IOW), ISA_6.13 (~IOW), ISA_7.13 (~IOW), PC_104.B13 (~IOW), RR5.5 (R4), U11.4, U11.5
~MEMCS16: ISA_1.63 (~MEMCS16), ISA_2.63 (~MEMCS16), ISA_3.63 (~MEMCS16), ISA_4.63 (~MEMCS16), ISA_5.63 (~MEMCS16), ISA_6.63 (~MEMCS16), ISA_7.63 (~MEMCS16), PC_104.D1 (~MEMCS16)
~MEMR: ISA_1.89 (~MEMR), ISA_2.89 (~MEMR), ISA_3.89 (~MEMR), ISA_4.89 (~MEMR), ISA_5.89 (~MEMR), ISA_6.89 (~MEMR), ISA_7.89 (~MEMR), PC_104.C9 (~MEMR), RR7.5 (R4), U2.22 (~OE)
~MEMW: ISA_1.90 (~MEMW), ISA_2.90 (~MEMW), ISA_3.90 (~MEMW), ISA_4.90 (~MEMW), ISA_5.90 (~MEMW), ISA_6.90 (~MEMW), ISA_7.90 (~MEMW), PC_104.C10 (~MEMW), RR7.6 (R5), SW1.2
~PS_ON: J1.16 (~PS_ON), U4.9 (Q)
~REFRESH: ISA_1.19 (~REFRESH), ISA_2.19 (~REFRESH), ISA_3.19 (~REFRESH), ISA_4.19 (~REFRESH), ISA_5.19 (~REFRESH), ISA_6.19 (~REFRESH), ISA_7.19 (~REFRESH), PC_104.B19 (~REFRESH)
~RESET: U10.11, U12.1 (~R)
~ROMCS: U1.19 (*P=Q), U2.20 (~CE)
~ROMW: RN1.3, SW1.13, U2.27 (~WE)
~SMEMR: ISA_1.12 (~SMEMR), ISA_2.12 (~SMEMR), ISA_3.12 (~SMEMR), ISA_4.12 (~SMEMR), ISA_5.12 (~SMEMR), ISA_6.12 (~SMEMR), ISA_7.12 (~SMEMR), PC_104.B12 (~SMEMR), RR5.4 (R3)
~SMEMW: ISA_1.11 (~SMEMW), ISA_2.11 (~SMEMW), ISA_3.11 (~SMEMW), ISA_4.11 (~SMEMW), ISA_5.11 (~SMEMW), ISA_6.11 (~SMEMW), ISA_7.11 (~SMEMW), PC_104.B11 (~SMEMW), RR5.3 (R2)
~SRDY: PC_104.B8 (~SRDY)

Notes on the sheet:
Support Circuitry
NOR gate from NANDs Input A Input B Output 0 0 1 0 1 0 1 0 0 1 1 0
Indicators/Headers
Option ROM
STANDBY LED
BLANKING CIRCUIT PRE-INITIAL CLOCK PULSE OR ON RESET
JP2 1-2 for 74x273 2-3 for 74x374
-5V Regulator
Terminating Resistors
Mounting Holes
TYING UNUSED LATCH INPUT PINS
POST Card - Logic
POST Card - Power
Power/Fans
Filter Caps
OR gate from NANDs Input A Input B Output 0 0 0 0 1 1 1 0 1 1 1 1
